pviniciusmeira/oshwpld/README.md

# OSHW with Programmable Logic Device
Project of a Development board to work with reconfigurable logic.
