pviniciusmeira/oshwpld/Projeto placa CPLD/Placa/placa_bottom.png

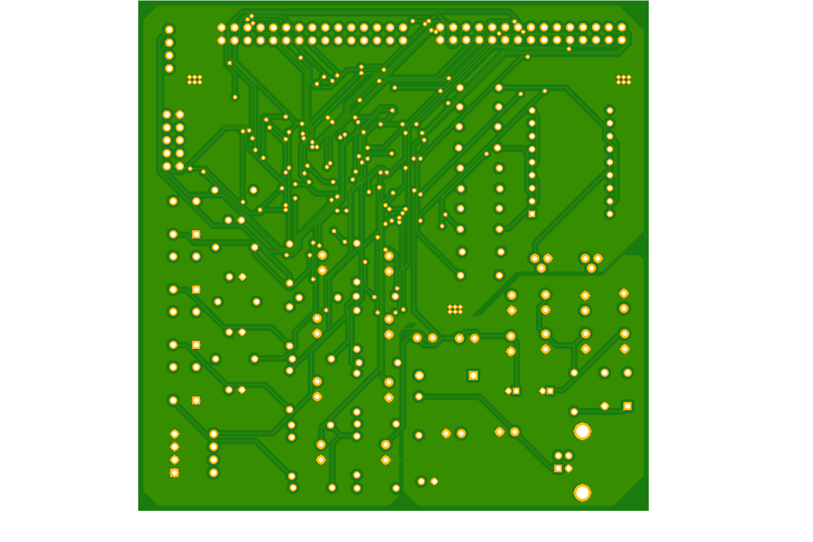
Projeto placa CPLD/Placa/placa_bottom.png
