pviniciusmeira/oshwpld/Projeto placa CPLD/Placa/placa_top.png

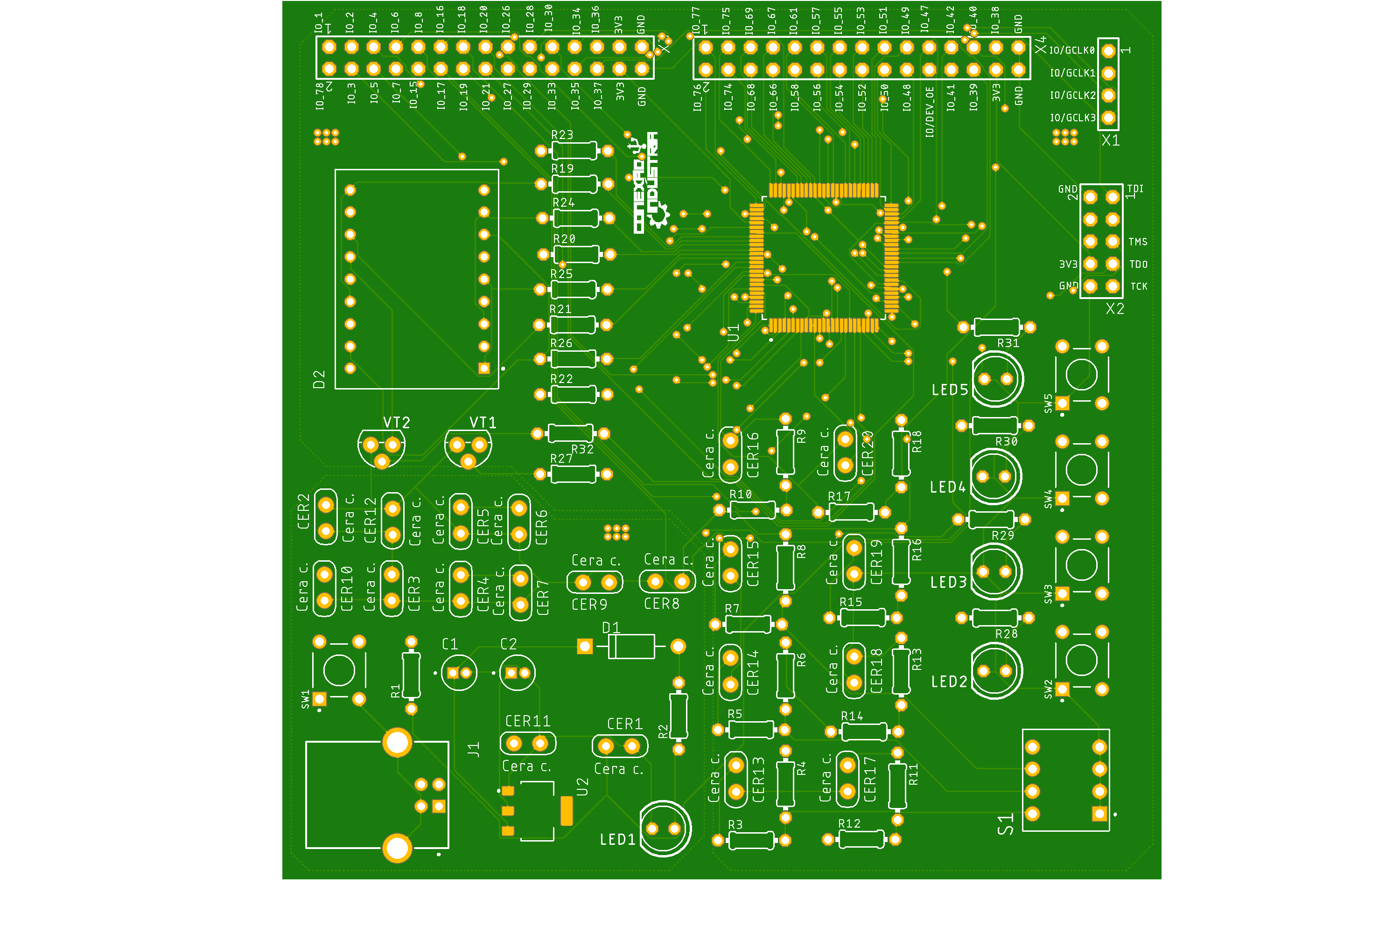
Projeto placa CPLD/Placa/placa_top.png
