pviniciusmeira/oshwpld/Projeto placa CPLD/Lista de componentes.xlsx

LISTA DE COMPONENTES PLACA OSHW COM CPLD
Componente | Quantidade | Preço unitário | Frete | Preço total
CPLD EPM240T100C5N | 1 | R$35.99 | R$16.70 | R$52.69
USB BLASTER | 1 | R$29.99 | R$9.50 | R$39.49
Placa de circuito impresso | 5 | R$2.06 | R$48.34 | R$58.64
Capacitor cerâmico 100nF | 20 | R$0.15 | R$0.00 | R$3.00
Capacitor eletrolítico 10uF | 2 | R$0.40 | R$0.00 | R$0.80
Diodo 1N4007 | 1 | R$0.30 | R$0.00 | R$0.30
Resistor 10KΩ 1/4W ± 5% | 9 | R$0.15 | R$0.00 | R$1.35
Resistor 1KΩ 1/4W ±5% | 10 | R$0.15 | R$0.00 | R$1.50
Resistor 330Ω 1/4W ±5% | 12 | R$0.15 | R$0.00 | R$1.80
Resistor 2,2KΩ 1/4W ±5% | 1 | R$0.15 | R$0.00 | R$0.15
Regulador de tensão AMS1117 3V3 | 1 | R$5.50 | R$0.00 | R$5.50
Conector USB B dip 90 | 1 | R$3.90 | R$0.00 | R$3.90
LED 5mm difuso verde | 1 | R$0.50 | R$0.00 | R$0.50
LED5mm difuso vermelho | 4 | R$0.50 | R$0.00 | R$2.00
Pushbutton 6x6x5mm | 5 | R$0.50 | R$0.00 | R$2.50
Dip switch 4 vias 180° | 1 | R$3.50 | R$0.00 | R$3.50
Transistor BC548 | 2 | R$0.40 | R$0.00 | R$0.80
Display 7 segmentos catodo comum 2 dígitos | 1 | R$3.90 | R$0.00 | R$3.90
Barra de pinos macho 2x40 vias | 2 | R$3.80 | R$0.00 | R$7.60
TOTAL |  |  |  | R$189.92
