pviniciusmeira/oshwpld/Projeto placa CPLD/Projeto_Eagle/esquemático_CPLD.dxf

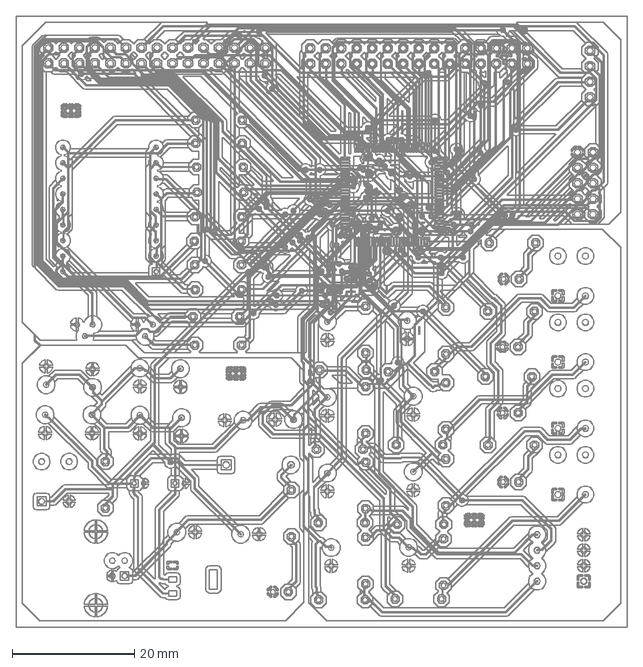
[picture p52: CAD file, 2022-11-18]
Projeto placa CPLD/Projeto_Eagle/esquemático_CPLD.dxf
100.0 x 100.0 mm
