pviniciusmeira/oshwpld/Projeto placa CPLD/Esquemático/Esquemático CPLD.pdf

# TSW-105-07-G-D

## TDI 23

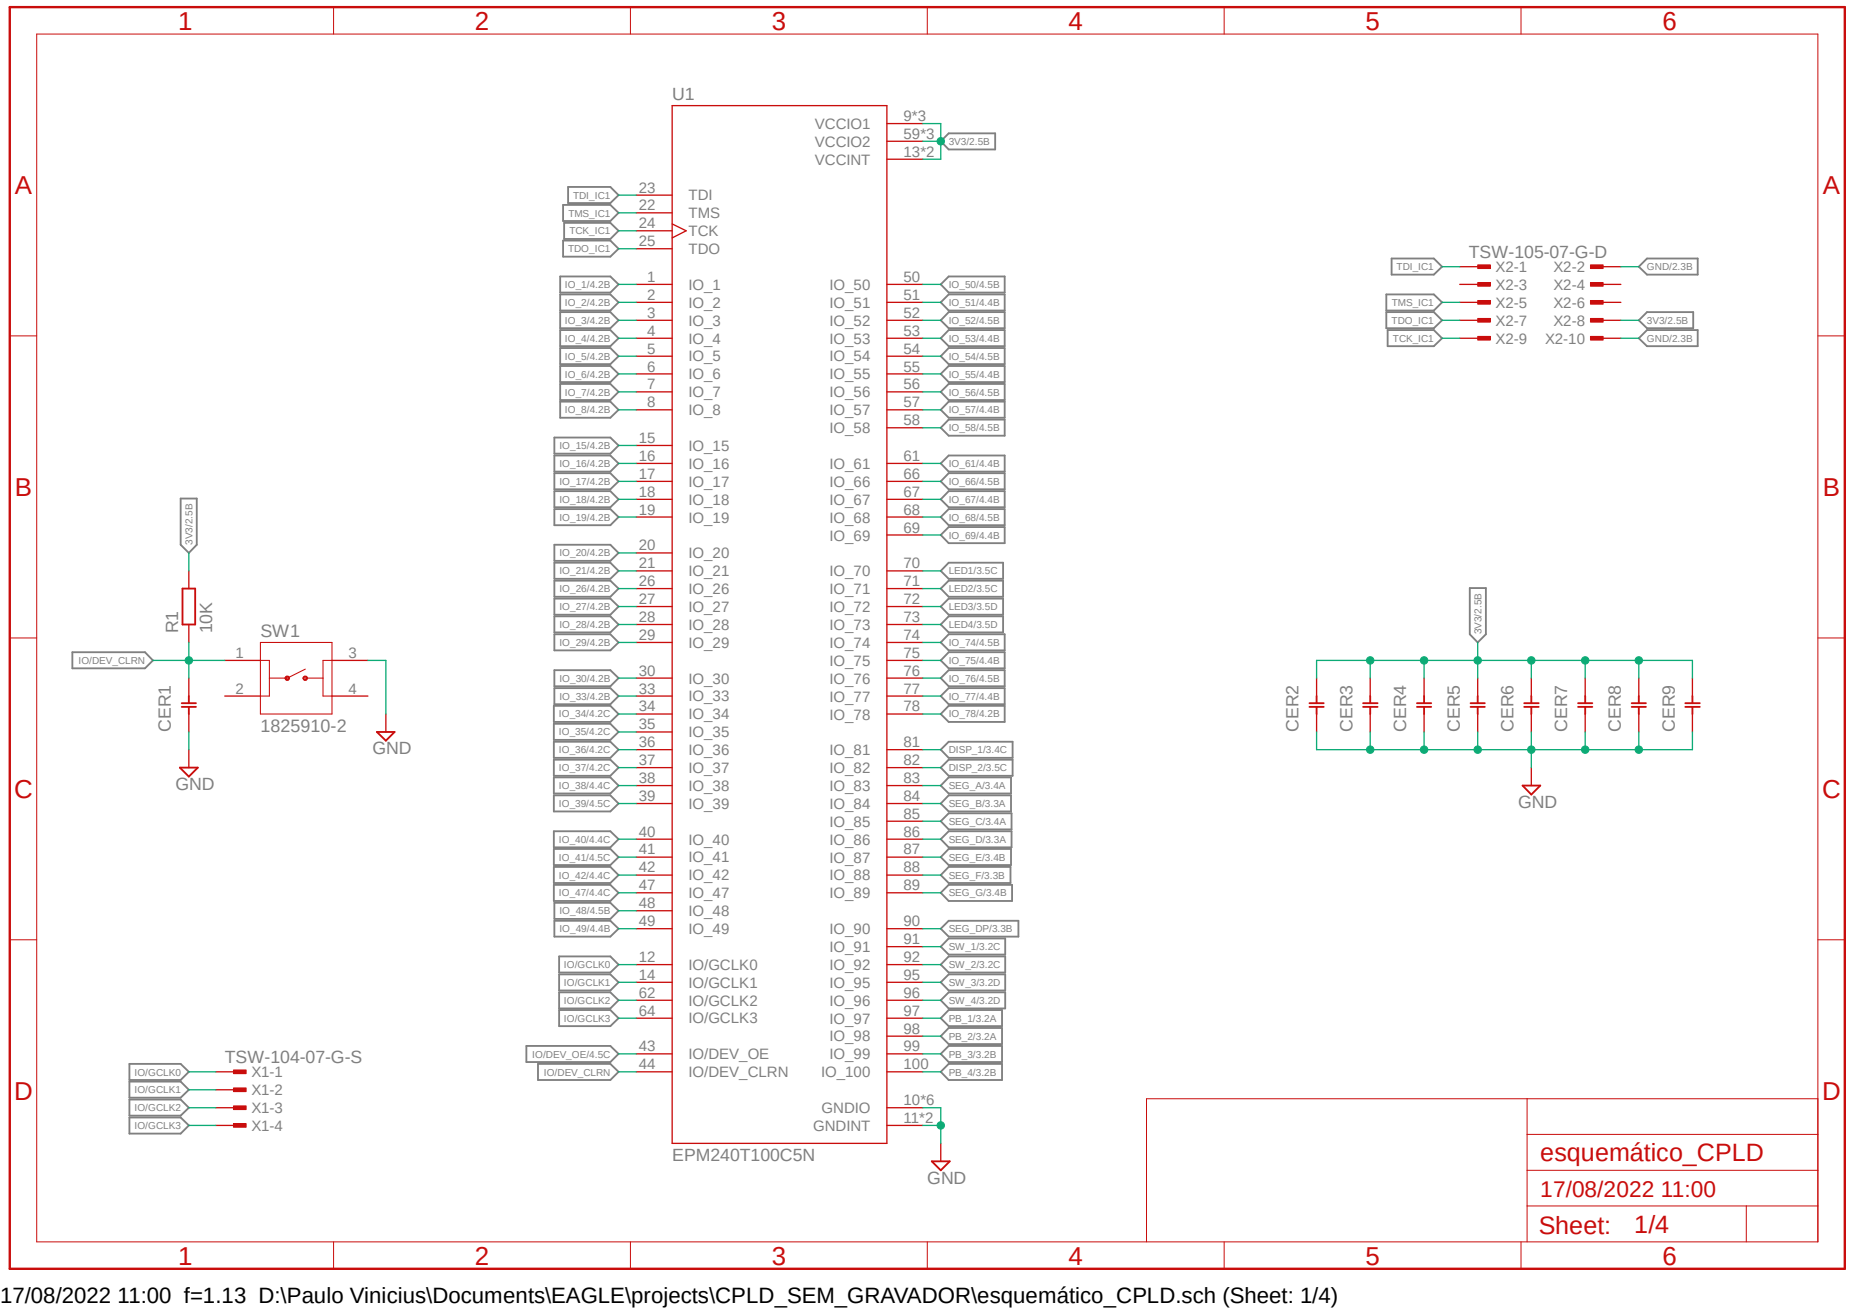
[picture p53: page 1]
EPM240T100C5N; GND; TSW-104-07-G-S; GND ¹⁰K; IO/GCLK0 12; IO/DEV_OE 43 IO/DEV_CLRN 44; TMS 22 TCK 24 TDO 25; GNDINT; 11*2 GNDIO; VCCINT; VCCIO1; VCCIO2; IO/GCLK1 14 IO/GCLK2 62 IO/GCLK3 64; CER²; CER³; CER⁴; CER⁵; CER⁶; CER⁷; CER⁸; CER⁹ R¹ CER¹; TDI_IC1; TMS_IC1; TCK_IC1; TDO_IC1; SEG_A/3.4A; SEG_B/3.3A; SEG_C/3.4A; SEG_D/3.3A; SEG_E/3.4B; SEG_F/3.3B; SEG_G/3.4B; SEG_DP/3.3B; DISP_1/3.4C; DISP_2/3.5C; IO/GCLK0; IO/GCLK1; IO/GCLK2; IO/GCLK3; IO/DEV_OE/4.5C; IO/DEV_CLRN; 3V³/2.5B ³V³/2.5B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

17/08/2022 11:00 f=1.13 D:\Paulo Vinicius\Documents\EAGLE\projects\CPLD_SEM_GRAVADOR\esquemático_CPLD.sch (Sheet: 1/4)

VIN 3 | VOUT | 2

U2

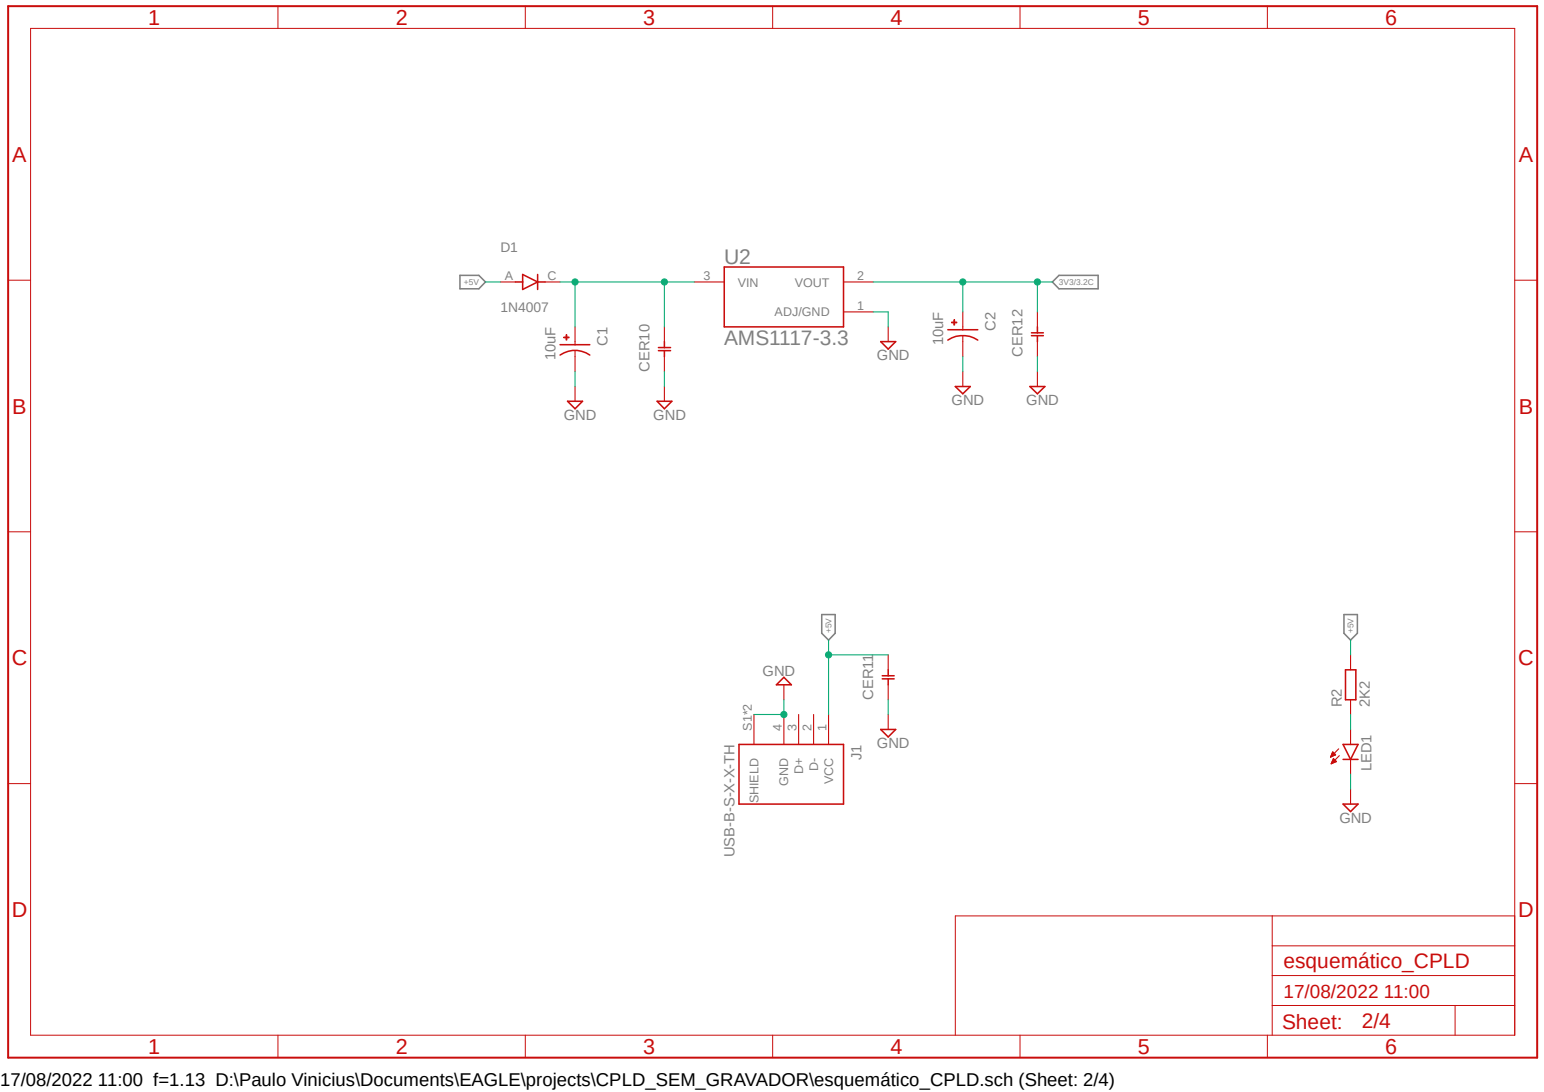
[picture p54: page 2]
GND; AMS1117-3.3; GND VCC; 3 GND; 4 SHIELD S1*2 J1 CER11 R2 LED1; ADJ/GND; CER¹⁰; C² CER¹²; Sheet:; esquemático_CPLD

17/08/2022 11:00 f=1.13 D:\Paulo Vinicius\Documents\EAGLE\projects\CPLD_SEM_GRAVADOR\esquemático_CPLD.sch (Sheet: 2/4) USB⁻B⁻S⁻X⁻X⁻TH

1825910-2

10K

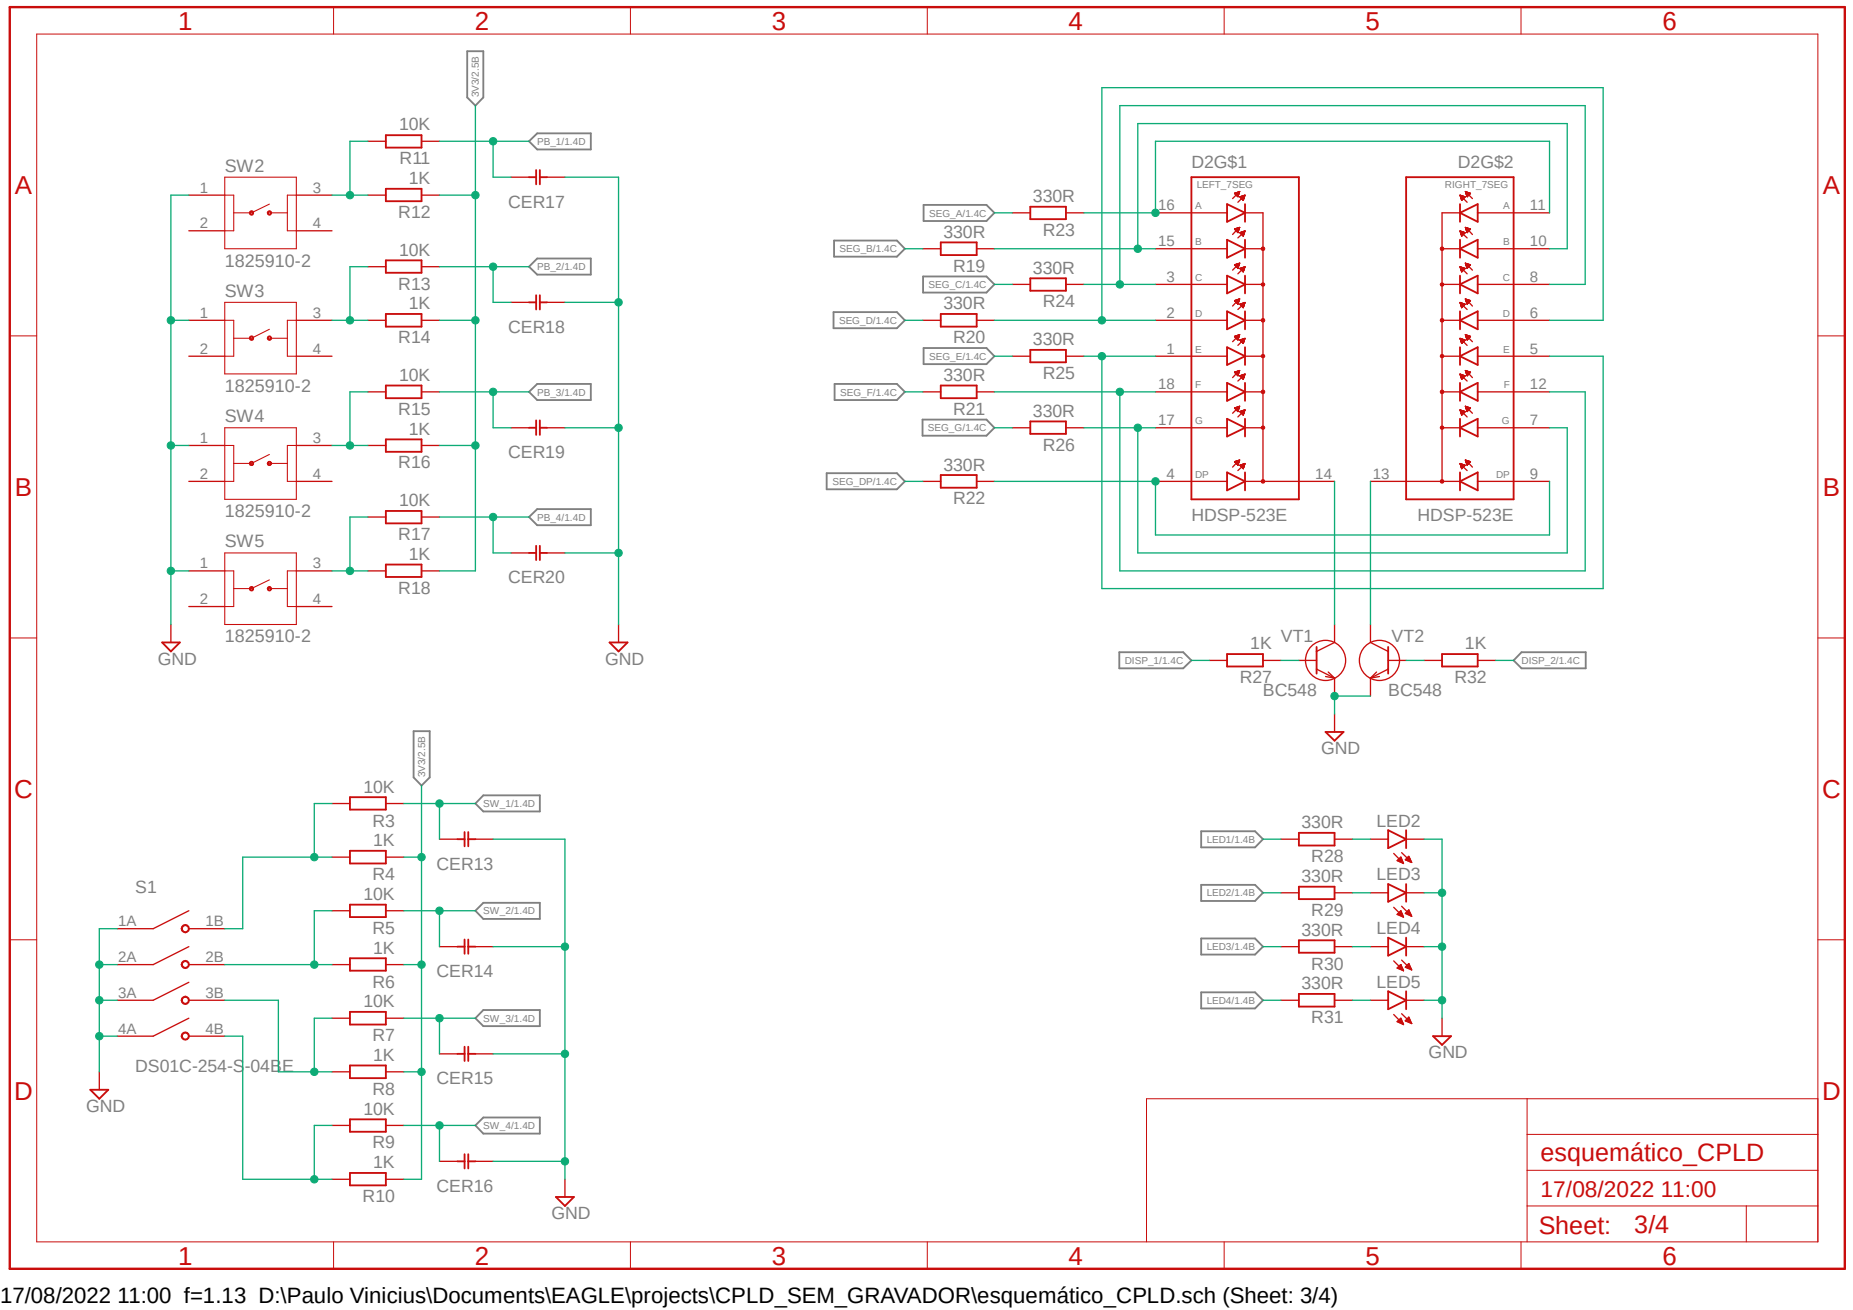
[picture p55: page 3]

17/08/2022 11:00 f=1.13 D:\Paulo Vinicius\Documents\EAGLE\projects\CPLD_SEM_GRAVADOR\esquemático_CPLD.sch (Sheet: 3/4)

A

A

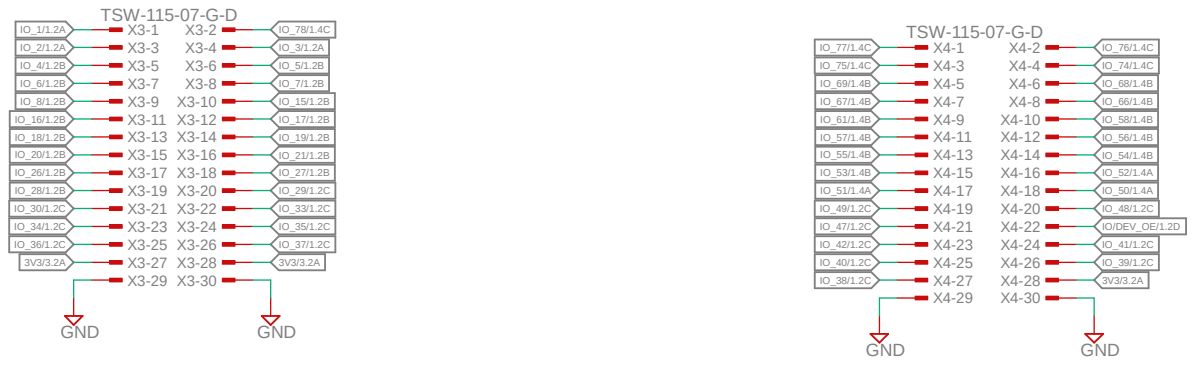
[picture p56: page 4]
TSW-115-07-G-D; GND; IO/DEV_OE/1.2D; Sheet:; esquemático_CPLD

17/08/2022 11:00 f=1.13 D:\Paulo Vinicius\Documents\EAGLE\projects\CPLD_SEM_GRAVADOR\esquemático_CPLD.sch (Sheet: 4/4)
