pviniciusmeira/oshwpld/Projeto placa CPLD/Projeto_Eagle/esquemático_CPLD.brd

## EAGLE design Projeto placa CPLD/Projeto_Eagle/esquemático_CPLD.brd (2022-12-08)

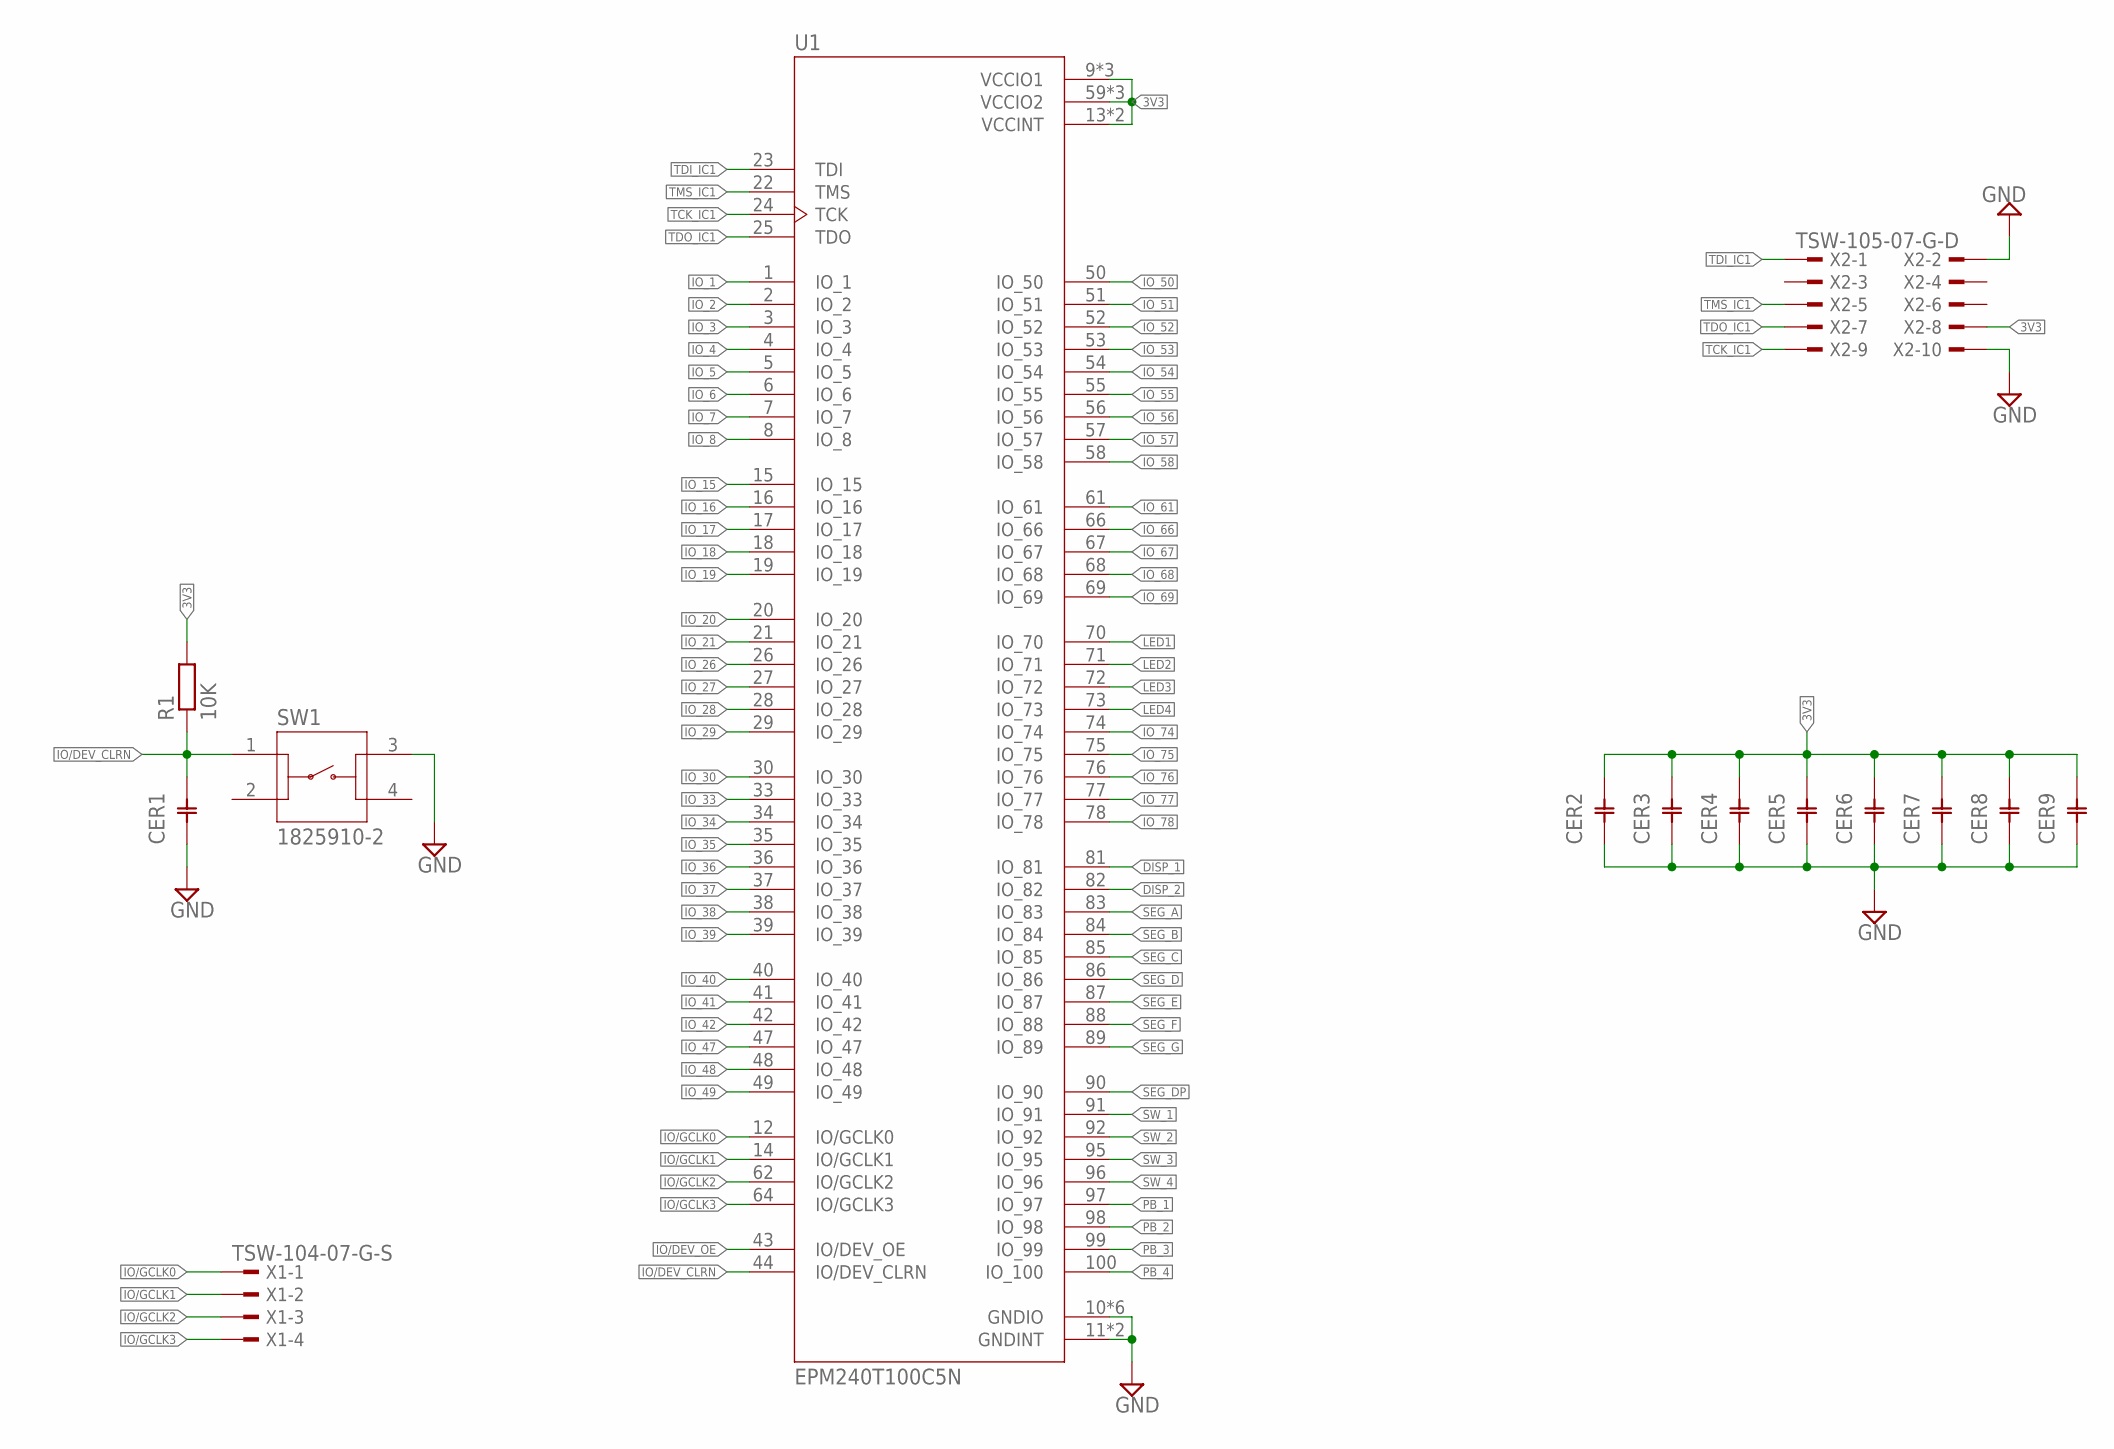
[picture p57: schematic esquemático_CPLD.sch, sheet 1]

Parts:
CER1, CER2, CER3, CER4, CER5, CER6, CER7, CER8, CER9: 100nF; CERACAPA
R1: 10K; 0204/7
SW1: 1825910-2; TE_1825910-2
U1: EPM240T100C5N; QFP50P1600X1600X120-100N
X1: TSW-104-07-G-S; TSW-104-XX-G-S
X2: TSW-105-07-G-D; TSW-105-XX-G-D

Connections:
3V3: CER2.P$2, CER3.P$2, CER4.P$2, CER5.P$2, CER6.P$2, CER7.P$2, CER8.P$2, CER9.P$2, R1.2, U1.9 (VCCIO1), U1.13 (VCCINT), U1.31 (VCCIO1), U1.45 (VCCIO1), U1.59 (VCCIO2), U1.63 (VCCINT), U1.80 (VCCIO2), U1.94 (VCCIO2), X2.8; also elsewhere on the board
DISP_1: U1.81 (IO_81); also elsewhere on the board
DISP_2: U1.82 (IO_82); also elsewhere on the board
GND: CER1.P$1, CER2.P$1, CER3.P$1, CER4.P$1, CER5.P$1, CER6.P$1, CER7.P$1, CER8.P$1, CER9.P$1, SW1.3, U1.10 (GNDIO), U1.11 (GNDINT), U1.32 (GNDIO), U1.46 (GNDIO), U1.60 (GNDIO), U1.65 (GNDINT), U1.79 (GNDIO), U1.93 (GNDIO), X2.2, X2.10; also elsewhere on the board
IO/DEV_CLRN: CER1.P$2, R1.1, SW1.1, U1.44 (IO/DEV_CLRN)
IO/DEV_OE: U1.43 (IO/DEV_OE); also elsewhere on the board
IO/GCLK0: U1.12 (IO/GCLK0), X1.1
IO/GCLK1: U1.14 (IO/GCLK1), X1.2
IO/GCLK2: U1.62 (IO/GCLK2), X1.3
IO/GCLK3: U1.64 (IO/GCLK3), X1.4
IO_1: U1.1 (IO_1); also elsewhere on the board
IO_2: U1.2 (IO_2); also elsewhere on the board
IO_3: U1.3 (IO_3); also elsewhere on the board
IO_4: U1.4 (IO_4); also elsewhere on the board
IO_5: U1.5 (IO_5); also elsewhere on the board
IO_6: U1.6 (IO_6); also elsewhere on the board
IO_7: U1.7 (IO_7); also elsewhere on the board
IO_8: U1.8 (IO_8); also elsewhere on the board
IO_15: U1.15 (IO_15); also elsewhere on the board
IO_16: U1.16 (IO_16); also elsewhere on the board
IO_17: U1.17 (IO_17); also elsewhere on the board
IO_18: U1.18 (IO_18); also elsewhere on the board
IO_19: U1.19 (IO_19); also elsewhere on the board
IO_20: U1.20 (IO_20); also elsewhere on the board
IO_21: U1.21 (IO_21); also elsewhere on the board
IO_26: U1.26 (IO_26); also elsewhere on the board
IO_27: U1.27 (IO_27); also elsewhere on the board
IO_28: U1.28 (IO_28); also elsewhere on the board
IO_29: U1.29 (IO_29); also elsewhere on the board
IO_30: U1.30 (IO_30); also elsewhere on the board
IO_33: U1.33 (IO_33); also elsewhere on the board
IO_34: U1.34 (IO_34); also elsewhere on the board
IO_35: U1.35 (IO_35); also elsewhere on the board
IO_36: U1.36 (IO_36); also elsewhere on the board
IO_37: U1.37 (IO_37); also elsewhere on the board
IO_38: U1.38 (IO_38); also elsewhere on the board
IO_39: U1.39 (IO_39); also elsewhere on the board
IO_40: U1.40 (IO_40); also elsewhere on the board
IO_41: U1.41 (IO_41); also elsewhere on the board
IO_42: U1.42 (IO_42); also elsewhere on the board
IO_47: U1.47 (IO_47); also elsewhere on the board
IO_48: U1.48 (IO_48); also elsewhere on the board
IO_49: U1.49 (IO_49); also elsewhere on the board
IO_50: U1.50 (IO_50); also elsewhere on the board
IO_51: U1.51 (IO_51); also elsewhere on the board
IO_52: U1.52 (IO_52); also elsewhere on the board
IO_53: U1.53 (IO_53); also elsewhere on the board
IO_54: U1.54 (IO_54); also elsewhere on the board
IO_55: U1.55 (IO_55); also elsewhere on the board
IO_56: U1.56 (IO_56); also elsewhere on the board
IO_57: U1.57 (IO_57); also elsewhere on the board
IO_58: U1.58 (IO_58); also elsewhere on the board
IO_61: U1.61 (IO_61); also elsewhere on the board
IO_66: U1.66 (IO_66); also elsewhere on the board
IO_67: U1.67 (IO_67); also elsewhere on the board
IO_68: U1.68 (IO_68); also elsewhere on the board
IO_69: U1.69 (IO_69); also elsewhere on the board
IO_74: U1.74 (IO_74); also elsewhere on the board
IO_75: U1.75 (IO_75); also elsewhere on the board
IO_76: U1.76 (IO_76); also elsewhere on the board
IO_77: U1.77 (IO_77); also elsewhere on the board
IO_78: U1.78 (IO_78); also elsewhere on the board
LED1: U1.70 (IO_70); also elsewhere on the board
LED2: U1.71 (IO_71); also elsewhere on the board
LED3: U1.72 (IO_72); also elsewhere on the board
LED4: U1.73 (IO_73); also elsewhere on the board
PB_1: U1.97 (IO_97); also elsewhere on the board
PB_2: U1.98 (IO_98); also elsewhere on the board
PB_3: U1.99 (IO_99); also elsewhere on the board
PB_4: U1.100 (IO_100); also elsewhere on the board
SEG_A: U1.83 (IO_83); also elsewhere on the board
SEG_B: U1.84 (IO_84); also elsewhere on the board
SEG_C: U1.85 (IO_85); also elsewhere on the board
SEG_D: U1.86 (IO_86); also elsewhere on the board
SEG_DP: U1.90 (IO_90); also elsewhere on the board
SEG_E: U1.87 (IO_87); also elsewhere on the board
SEG_F: U1.88 (IO_88); also elsewhere on the board
SEG_G: U1.89 (IO_89); also elsewhere on the board
SW_1: U1.91 (IO_91); also elsewhere on the board
SW_2: U1.92 (IO_92); also elsewhere on the board
SW_3: U1.95 (IO_95); also elsewhere on the board
SW_4: U1.96 (IO_96); also elsewhere on the board
TCK_IC1: U1.24 (TCK), X2.9
TDI_IC1: U1.23 (TDI), X2.1
TDO_IC1: U1.25 (TDO), X2.7
TMS_IC1: U1.22 (TMS), X2.5

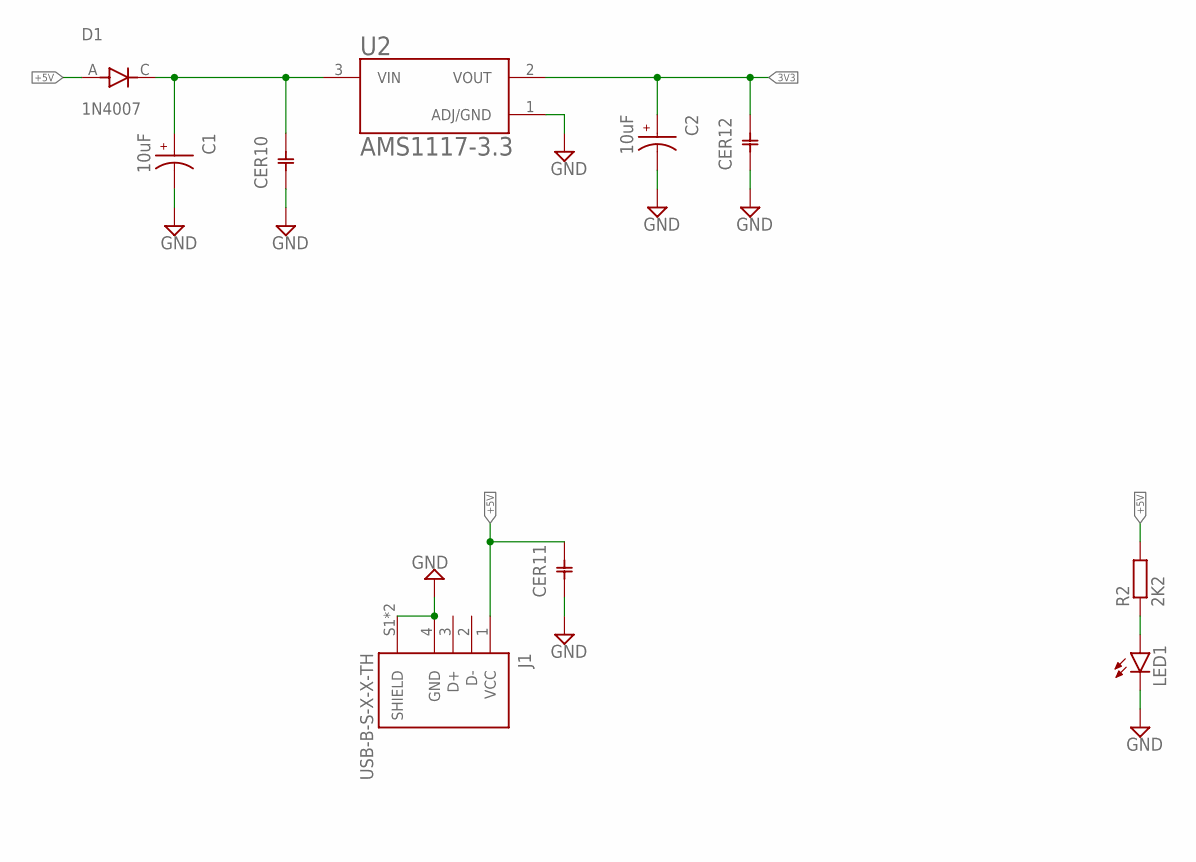
[picture p58: schematic esquemático_CPLD.sch, sheet 2]

Parts:
C1, C2: 10uF; CAPPRD150W45D400H700
CER10, CER11, CER12: 100nF; CERACAPA
D1: 1N4007; DIOAD1060W80L520D270
J1: USB-B-S-X-X-TH; SAMTEC_USB-B-S-X-X-TH
LED1: LED5MM
R2: 2K2; 0204/7
U2: AMS1117-3.3; SOT229P700X180-4N

Connections:
3V3: C2.P, CER12.P$2, U2.2 (VOUT); also elsewhere on the board
+5V: CER11.P$2, D1.A, J1.1 (VCC), R2.2
GND: C1.N, C2.N, CER10.P$1, CER11.P$1, CER12.P$1, J1.4 (GND), J1.S1 (SHIELD), J1.S2 (SHIELD), LED1.K (C), U2.1 (ADJ/GND); also elsewhere on the board
unnamed: LED1.A, R2.1
unnamed: C1.P, CER10.P$2, D1.C, U2.3 (VIN)

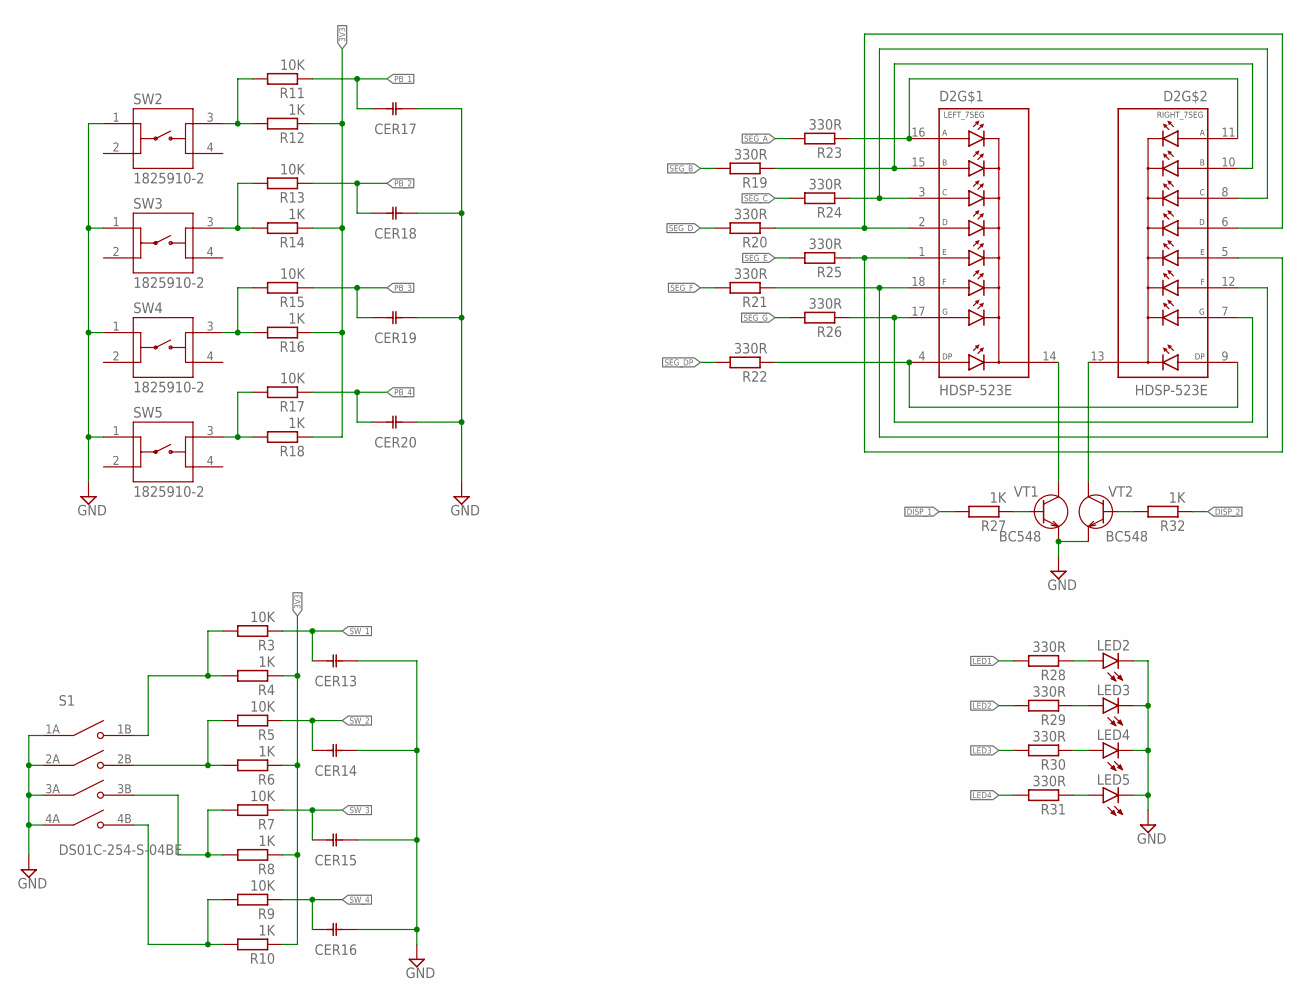
[picture p59: schematic esquemático_CPLD.sch, sheet 3]

Parts:
CER13, CER14, CER15, CER16, CER17, CER18, CER19, CER20: 100nF; CERACAPA
D2: HDSP-523E; LED_HDSP-523E
LED2, LED3, LED4, LED5: LED5MM
R3, R5, R7, R9, R11, R13, R15, R17: 10K; 0204/7
R4, R6, R8, R10, R12, R14, R16, R18, R27, R32: 1K; 0204/7
R19, R20, R21, R22, R23, R24, R25, R26, R28, R29, R30, R31: 330R; 0204/7
S1: DS01C-254-S-04BE; SW_DS01C-254-S-04BE
SW2, SW3, SW4, SW5: 1825910-2; TE_1825910-2
VT1, VT2: BC548; TO92

Connections:
3V3: R4.1, R6.1, R8.1, R10.1, R12.1, R14.1, R16.1, R18.1; also elsewhere on the board
DISP_1: R27.2; also elsewhere on the board
DISP_2: R32.1; also elsewhere on the board
GND: CER13.P$1, CER14.P$1, CER15.P$1, CER16.P$1, CER17.P$1, CER18.P$1, CER19.P$1, CER20.P$1, LED2.K (C), LED3.K (C), LED4.K (C), LED5.K (C), S1.1A (COM1), S1.2A (COM2), S1.3A (COM3), S1.4A (COM4), SW2.1, SW3.1, SW4.1, SW5.1, VT1.E, VT2.E; also elsewhere on the board
LED1: R28.2; also elsewhere on the board
LED2: R29.2; also elsewhere on the board
LED3: R30.2; also elsewhere on the board
LED4: R31.2; also elsewhere on the board
unnamed: R11.2, R12.2, SW2.3
unnamed: R3.2, R4.2, S1.1B (NO1)
unnamed: R5.2, R6.2, S1.2B (NO2)
unnamed: R9.2, R10.2, S1.4B (NO4)
unnamed: R7.2, R8.2, S1.3B (NO3)
unnamed: R13.2, R14.2, SW3.3
unnamed: R15.2, R16.2, SW4.3
unnamed: R17.2, R18.2, SW5.3
unnamed: D2.11 (A_2), D2.16 (A_1), R23.1
unnamed: D2.10 (B_2), D2.15 (B_1), R19.1
unnamed: D2.3 (C_1), D2.8 (C_2), R24.1
unnamed: D2.2 (D_1), D2.6 (D_2), R20.1
unnamed: D2.4 (DP_1), D2.9 (DP_2), R22.1
unnamed: D2.7 (G_2), D2.17 (G_1), R26.1
unnamed: D2.12 (F_2), D2.18 (F_1), R21.1
unnamed: D2.1 (E_1), D2.5 (E_2), R25.1
unnamed: D2.13 (COM_2), VT2.C
unnamed: D2.14 (COM_1), VT1.C
unnamed: R27.1, VT1.B
unnamed: R32.2, VT2.B
unnamed: LED2.A, R28.1
unnamed: LED3.A, R29.1
unnamed: LED4.A, R30.1
unnamed: LED5.A, R31.1
PB_1: CER17.P$2, R11.1; also elsewhere on the board
PB_2: CER18.P$2, R13.1; also elsewhere on the board
PB_3: CER19.P$2, R15.1; also elsewhere on the board
PB_4: CER20.P$2, R17.1; also elsewhere on the board
SEG_A: R23.2; also elsewhere on the board
SEG_B: R19.2; also elsewhere on the board
SEG_C: R24.2; also elsewhere on the board
SEG_D: R20.2; also elsewhere on the board
SEG_DP: R22.2; also elsewhere on the board
SEG_E: R25.2; also elsewhere on the board
SEG_F: R21.2; also elsewhere on the board
SEG_G: R26.2; also elsewhere on the board
SW_1: CER13.P$2, R3.1; also elsewhere on the board
SW_2: CER14.P$2, R5.1; also elsewhere on the board
SW_3: CER15.P$2, R7.1; also elsewhere on the board
SW_4: CER16.P$2, R9.1; also elsewhere on the board

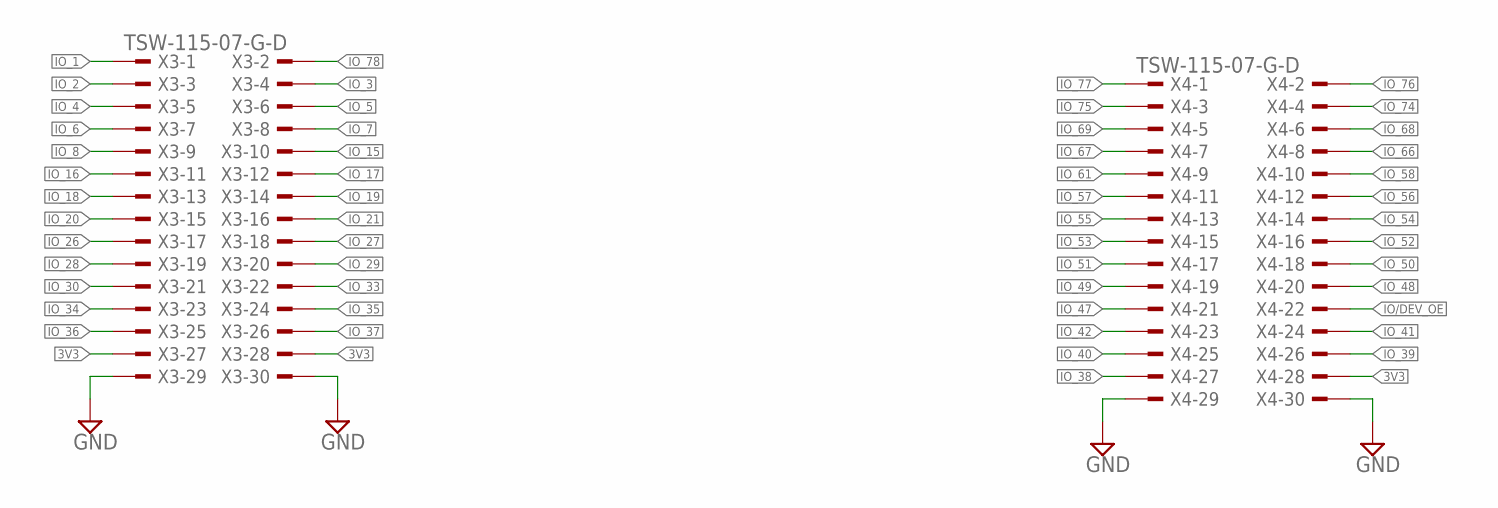
[picture p60: schematic esquemático_CPLD.sch, sheet 4]

Parts:
X3, X4: TSW-115-07-G-D; TSW-115-XX-G-D

Connections:
3V3: X3.27, X3.28, X4.28; also elsewhere on the board
GND: X3.29, X3.30, X4.29, X4.30; also elsewhere on the board
IO/DEV_OE: X4.22; also elsewhere on the board
IO_1: X3.1; also elsewhere on the board
IO_2: X3.3; also elsewhere on the board
IO_3: X3.4; also elsewhere on the board
IO_4: X3.5; also elsewhere on the board
IO_5: X3.6; also elsewhere on the board
IO_6: X3.7; also elsewhere on the board
IO_7: X3.8; also elsewhere on the board
IO_8: X3.9; also elsewhere on the board
IO_15: X3.10; also elsewhere on the board
IO_16: X3.11; also elsewhere on the board
IO_17: X3.12; also elsewhere on the board
IO_18: X3.13; also elsewhere on the board
IO_19: X3.14; also elsewhere on the board
IO_20: X3.15; also elsewhere on the board
IO_21: X3.16; also elsewhere on the board
IO_26: X3.17; also elsewhere on the board
IO_27: X3.18; also elsewhere on the board
IO_28: X3.19; also elsewhere on the board
IO_29: X3.20; also elsewhere on the board
IO_30: X3.21; also elsewhere on the board
IO_33: X3.22; also elsewhere on the board
IO_34: X3.23; also elsewhere on the board
IO_35: X3.24; also elsewhere on the board
IO_36: X3.25; also elsewhere on the board
IO_37: X3.26; also elsewhere on the board
IO_38: X4.27; also elsewhere on the board
IO_39: X4.26; also elsewhere on the board
IO_40: X4.25; also elsewhere on the board
IO_41: X4.24; also elsewhere on the board
IO_42: X4.23; also elsewhere on the board
IO_47: X4.21; also elsewhere on the board
IO_48: X4.20; also elsewhere on the board
IO_49: X4.19; also elsewhere on the board
IO_50: X4.18; also elsewhere on the board
IO_51: X4.17; also elsewhere on the board
IO_52: X4.16; also elsewhere on the board
IO_53: X4.15; also elsewhere on the board
IO_54: X4.14; also elsewhere on the board
IO_55: X4.13; also elsewhere on the board
IO_56: X4.12; also elsewhere on the board
IO_57: X4.11; also elsewhere on the board
IO_58: X4.10; also elsewhere on the board
IO_61: X4.9; also elsewhere on the board
IO_66: X4.8; also elsewhere on the board
IO_67: X4.7; also elsewhere on the board
IO_68: X4.6; also elsewhere on the board
IO_69: X4.5; also elsewhere on the board
IO_74: X4.4; also elsewhere on the board
IO_75: X4.3; also elsewhere on the board
IO_76: X4.2; also elsewhere on the board
IO_77: X4.1; also elsewhere on the board
IO_78: X3.2; also elsewhere on the board

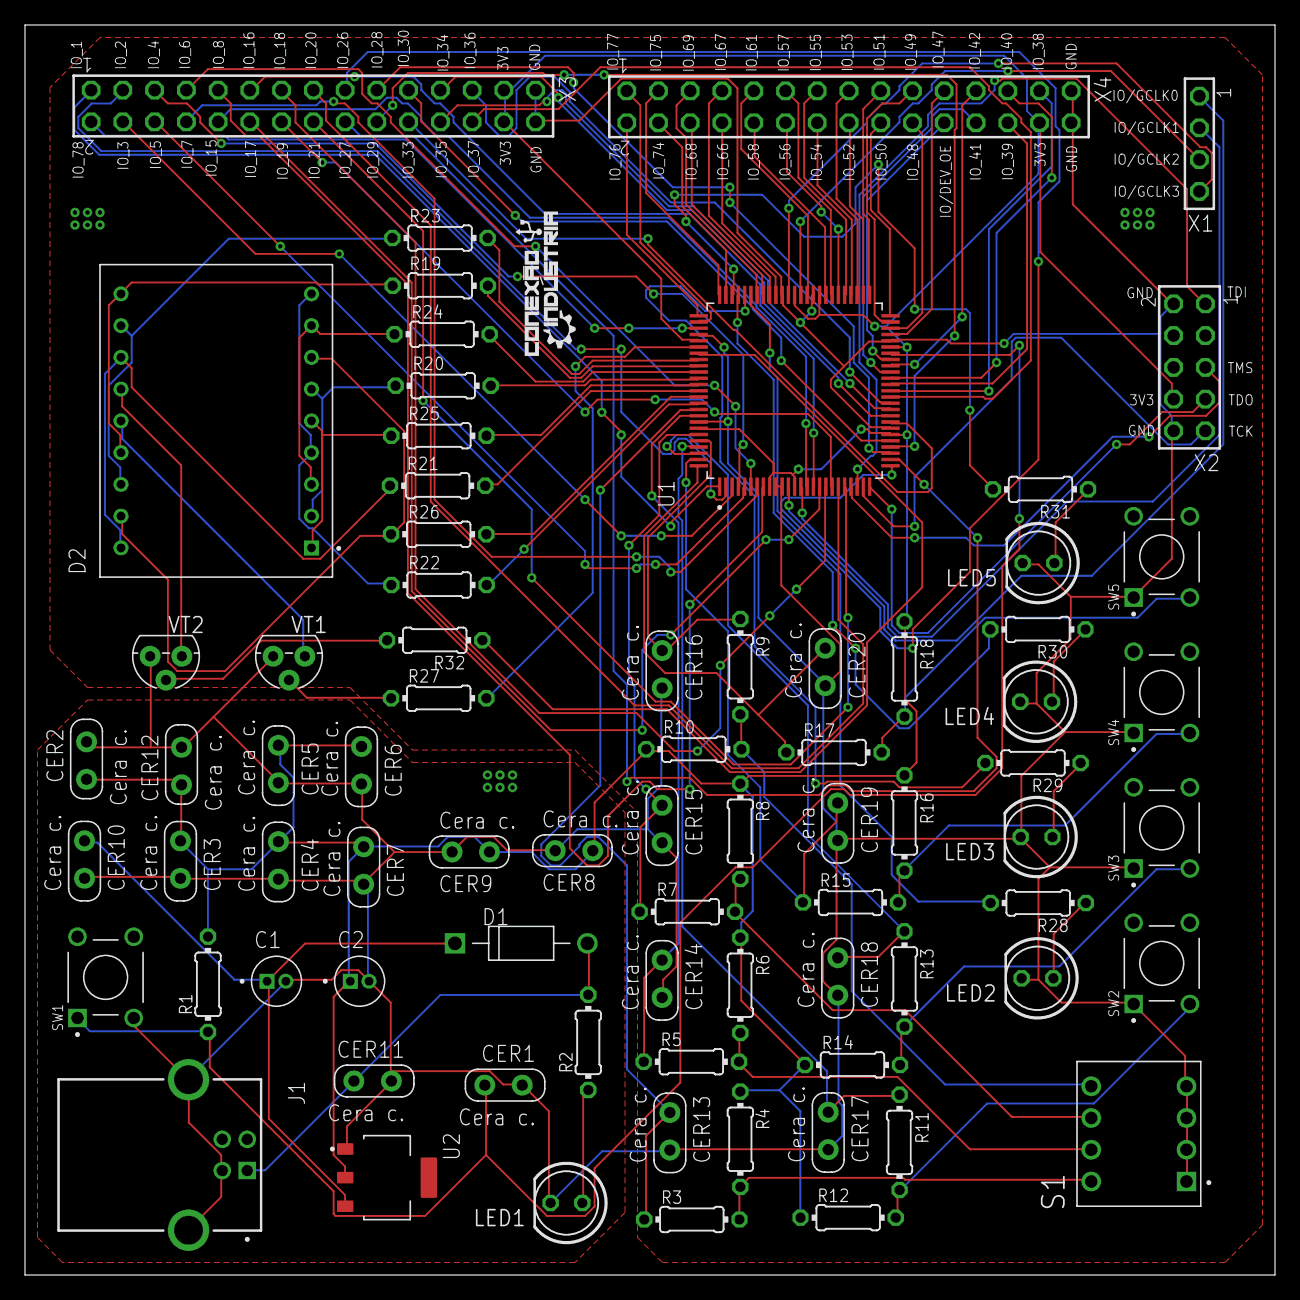
[picture p61: board esquemático_CPLD.brd from above]

Board: 2 copper layers, 100.0 x 100.0 mm, 76 parts (0 on the bottom side), 113 nets.
